myowndevice/UVmetr/(list of files, cad)

Other CAD files:
uvmetr/Project/STM8S_StdPeriph_Template/STVD/Cosmic/stm8s003.stp
uvmetr/Project/STM8S_StdPeriph_Template/STVD/Cosmic/stm8s003_Programmer/stm8s003_STVP.stp
uvmetr/Project/STM8S_StdPeriph_Template/STVD/Raisonance/stm8s207.stp
uvmetr/Project/STM8S_StdPeriph_Template/STVD/Cosmic/stm8af622x.stp
uvmetr/Project/STM8S_StdPeriph_Template/STVD/Raisonance/stm8s903.stp
uvmetr/Project/STM8S_StdPeriph_Template/STVD/Cosmic/stm8s007.stp
uvmetr/Project/STM8S_StdPeriph_Template/STVD/Raisonance/stm8af62ax.stp
uvmetr/Project/STM8S_StdPeriph_Template/STVD/Cosmic/stm8af52ax.stp
uvmetr/Project/STM8S_StdPeriph_Template/STVD/Raisonance/stm8af626x.stp
uvmetr/Project/STM8S_StdPeriph_Template/STVD/Cosmic/stm8af62ax.stp
uvmetr/Project/STM8S_StdPeriph_Template/STVD/Raisonance/stm8s007.stp
uvmetr/Project/STM8S_StdPeriph_Template/STVD/Cosmic/stm8s103.stp
uvmetr/Project/STM8S_StdPeriph_Template/STVD/Raisonance/stm8s003.stp
uvmetr/Project/STM8S_StdPeriph_Template/STVD/Cosmic/stm8s105.stp
uvmetr/Project/STM8S_StdPeriph_Template/STVD/Raisonance/stm8af622x.stp
uvmetr/Project/STM8S_StdPeriph_Template/STVD/Cosmic/stm8af626x.stp
uvmetr/Project/STM8S_StdPeriph_Template/STVD/Raisonance/stm8s208.stp
uvmetr/Project/STM8S_StdPeriph_Template/STVD/Cosmic/stm8s903.stp
uvmetr/Project/STM8S_StdPeriph_Template/STVD/Raisonance/stm8s105.stp
uvmetr/Project/STM8S_StdPeriph_Template/STVD/Cosmic/stm8s208.stp
uvmetr/Project/STM8S_StdPeriph_Template/STVD/Raisonance/stm8s005.stp
uvmetr/Project/STM8S_StdPeriph_Template/STVD/Cosmic/stm8s207.stp
uvmetr/Project/STM8S_StdPeriph_Template/STVD/Raisonance/stm8af52ax.stp
uvmetr/Project/STM8S_StdPeriph_Template/STVD/Cosmic/stm8s005.stp
uvmetr/Project/STM8S_StdPeriph_Template/STVD/Raisonance/stm8s103.stp
