myowndevice/UVmetr/(list of files, drawings)

Other design files:
kicad/uvmetr.dsn
