myowndevice/UVmetr/kicad/uvmetr.kicad_pcb

## KiCad design kicad/uvmetr.kicad_pcb (2019-02-16)

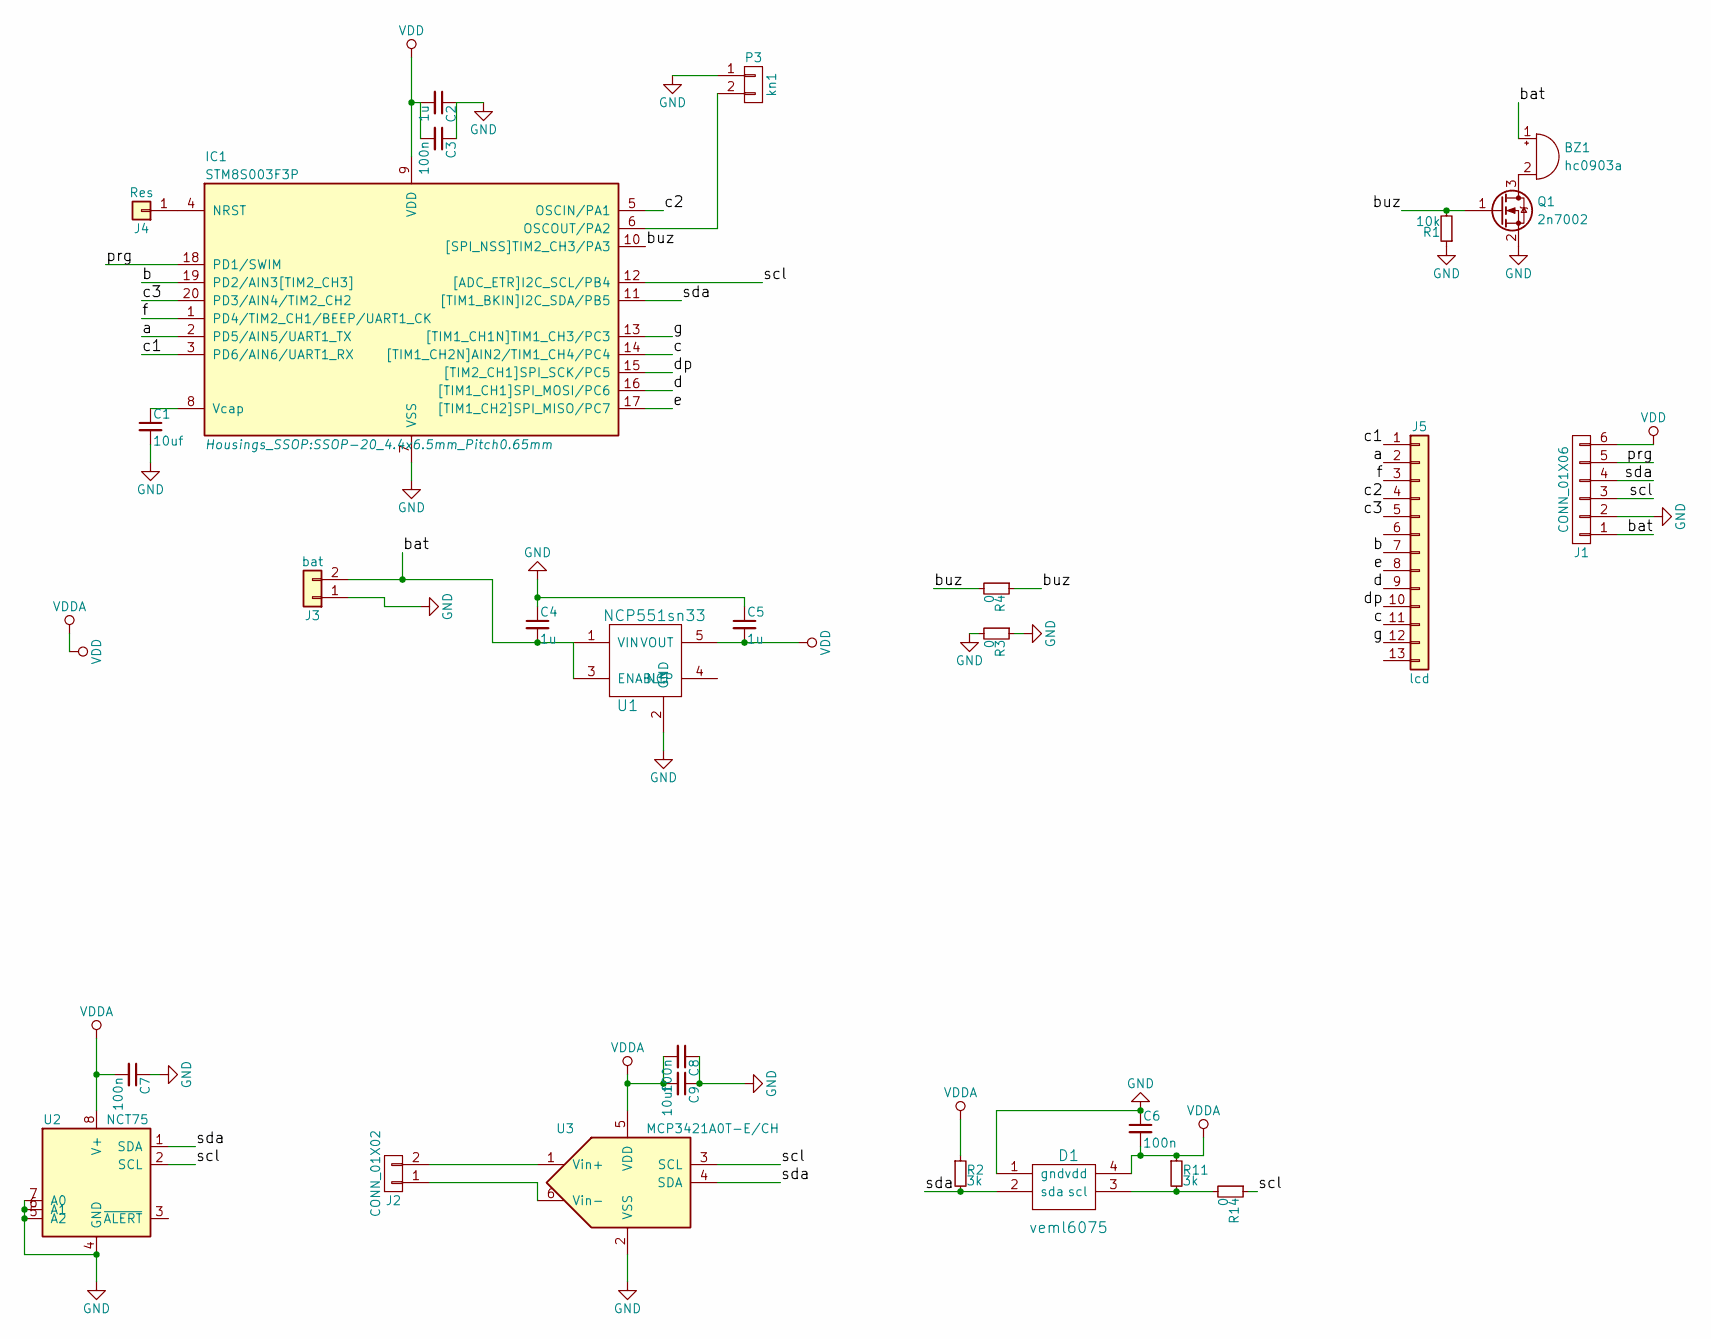
[picture p1: schematic uvmetr.sch]

Parts:
BZ1: hc0903a
C1, C9: 10uf; C_0805_HandSoldering
C2, C4, C5: 1u; C_0805_HandSoldering
C3, C6, C7, C8: 100n; C_0603_HandSoldering
D1: veml6075
IC1: STM8S003F3P; SSOP-20_4.4x6.5mm_Pitch0.65mm
J1: CONN_01X06; Pin_Header_Angled_1x06_Pitch2.54mm
J2: CONN_01X02; Pin_Header_Angled_1x02_Pitch2.54mm
J3: bat; Pin_Header_Angled_1x02_Pitch2.54mm
J4: Res; wirepad_mini
J5: lcd; PIN13_Pitch1_5_lcd
P3: kn1; SW_PUSH_6mm
Q1: 2n7002; SOT-23
R1: 10k; R_0603_HandSoldering
R2, R11: 3k; R_0603_HandSoldering
R3, R4, R14: 0; R_0603_HandSoldering
U1: NCP551sn33; SOT-23-5_HandSoldering
U2: NCT75; SSOP-8_2.95x2.8mm_Pitch0.65mm
U3: MCP3421A0T-E/CH; SOT-23-6_Handsoldering

Connections:
/a: IC1.2 (PD5/AIN5/UART1_TX), J5.2
/b: IC1.19 (PD2/AIN3[TIM2_CH3]), J5.7
/bat: BZ1.1 (-), C4.2, J1.1, J3.2, U1.1 (VIN), U1.3 (ENABLE)
/buz: IC1.10 ([SPI_NSS]TIM2_CH3/PA3), Q1.1 (G), R1.2, R4.1, R4.2
/c: IC1.14 ([TIM1_CH2N]AIN2/TIM1_CH4/PC4), J5.11
/c1: IC1.3 (PD6/AIN6/UART1_RX), J5.1
/c2: IC1.5 (OSCIN/PA1), J5.4
/c3: IC1.20 (PD3/AIN4/TIM2_CH2), J5.5
/d: IC1.16 ([TIM1_CH1]SPI_MOSI/PC6), J5.9
/dp: IC1.15 ([TIM2_CH1]SPI_SCK/PC5), J5.10
/e: IC1.17 ([TIM1_CH2]SPI_MISO/PC7), J5.8
/f: IC1.1 (PD4/TIM2_CH1/BEEP/UART1_CK), J5.3
/g: IC1.13 ([TIM1_CH1N]TIM1_CH3/PC3), J5.12
/prg: IC1.18 (PD1/SWIM), J1.5
/scl: IC1.12 ([ADC_ETR]I2C_SCL/PB4), J1.3, R14.1, U2.2 (SCL), U3.3 (SCL)
/sda: D1.2 (sda), IC1.11 ([TIM1_BKIN]I2C_SDA/PB5), J1.4, R2.2, U2.1 (SDA), U3.4 (SDA)
GND: C1.2, C2.1, C3.1, C4.1, C5.1, C6.1, C7.1, C8.1, C9.1, D1.1 (gnd), IC1.7 (VSS), J1.2, J3.1, P3.1, Q1.2 (S), R1.1, R3.1, R3.2, U1.2 (GND), U2.4 (GND), U2.5 (A2), U2.6 (A1), U2.7 (A0), U3.2 (VSS)
unnamed: BZ1.2 (+), Q1.3 (D)
unnamed: C1.1, IC1.8 (Vcap)
unnamed: D1.3 (scl), R11.2, R14.2
unnamed: IC1.4 (NRST), J4.1
unnamed: IC1.6 (OSCOUT/PA2), P3.2
unnamed: J2.1, U3.6 (Vin-)
unnamed: J2.2, U3.1 (Vin+)
VDD: C2.2, C3.2, C5.2, C6.2, C7.2, C8.2, C9.2, D1.4 (vdd), IC1.9 (VDD), J1.6, R2.1, R11.1, U1.5 (VOUT), U2.8 (V+), U3.5 (VDD)

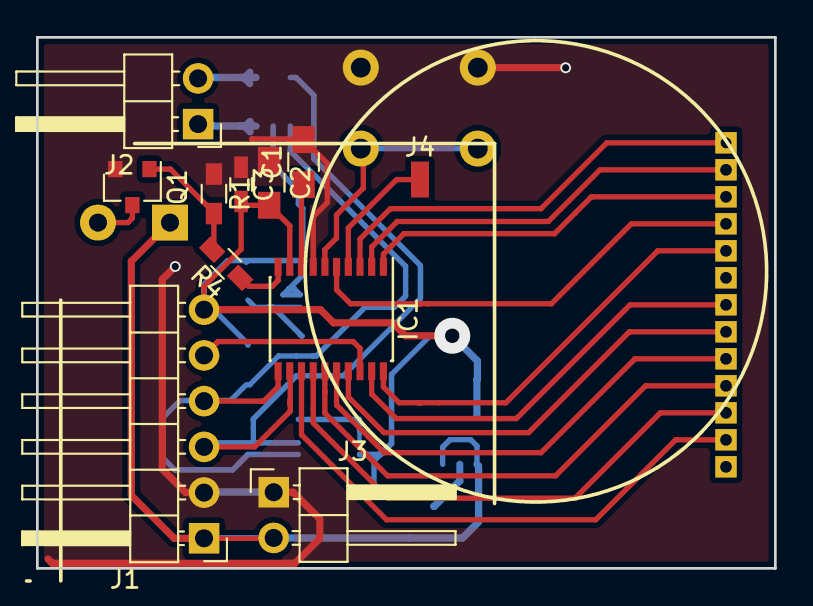
[picture p2: board uvmetr.kicad_pcb from above]

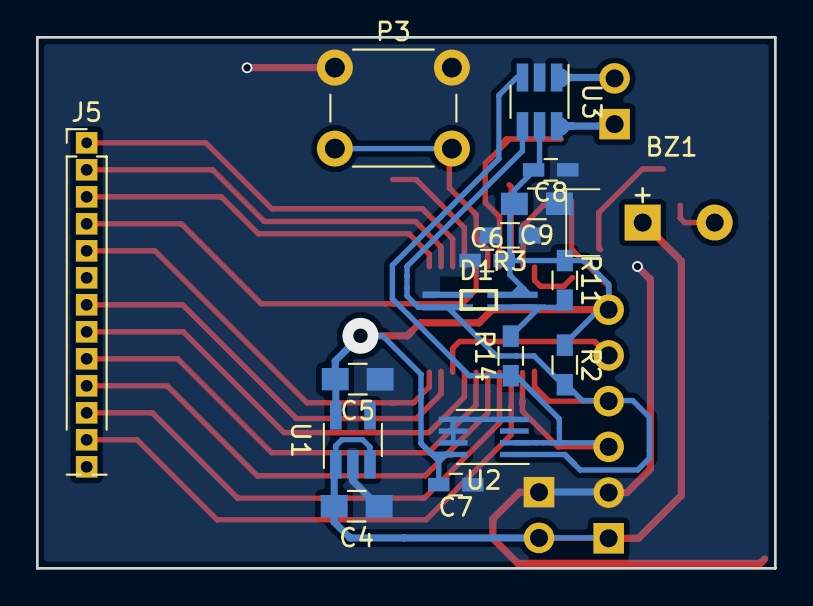
[picture p3: board uvmetr.kicad_pcb from below]

Board: 2 copper layers, 41.0 x 29.5 mm, 28 parts (17 on the bottom side), 25 nets.
